hopkira/k9-chess-angular/tessel/README.md

# Tessel 2 Controller

Tessel 2 is not currently used in the design of the robot, with the LIDAR and ADC being monitored directly by the Pi
