hopkira/k9-chess-angular/img/Androids of Tara - Doctor talking to K9.png

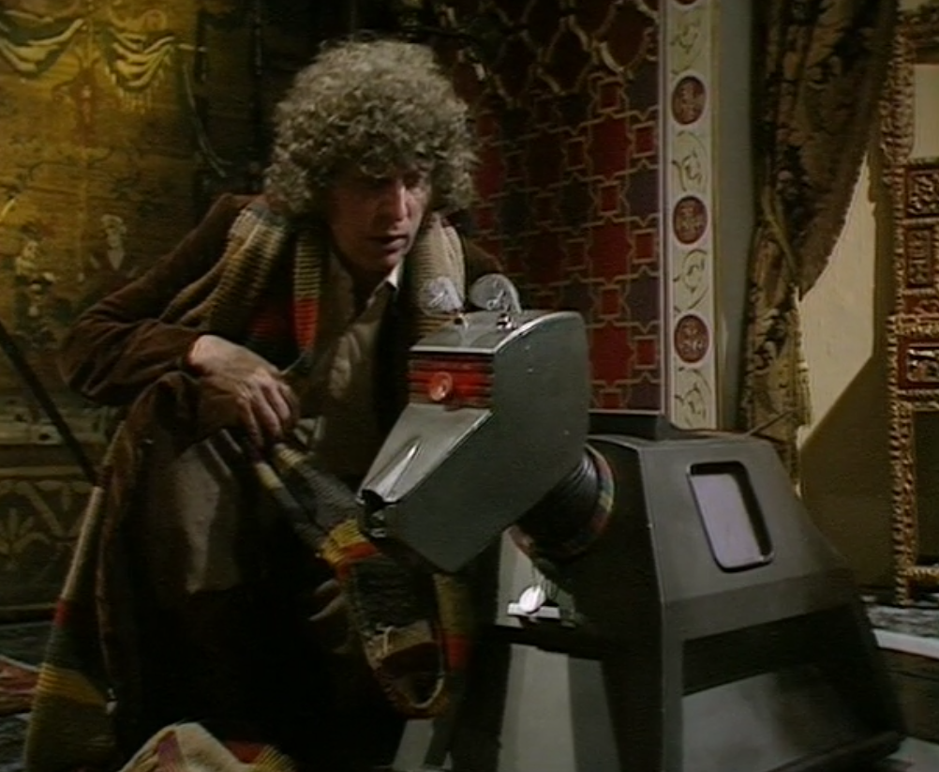
img/Androids of Tara - Doctor talking to K9.png
