hopkira/k9-chess-angular/img/Androids of Tara - headshot in lodge.png

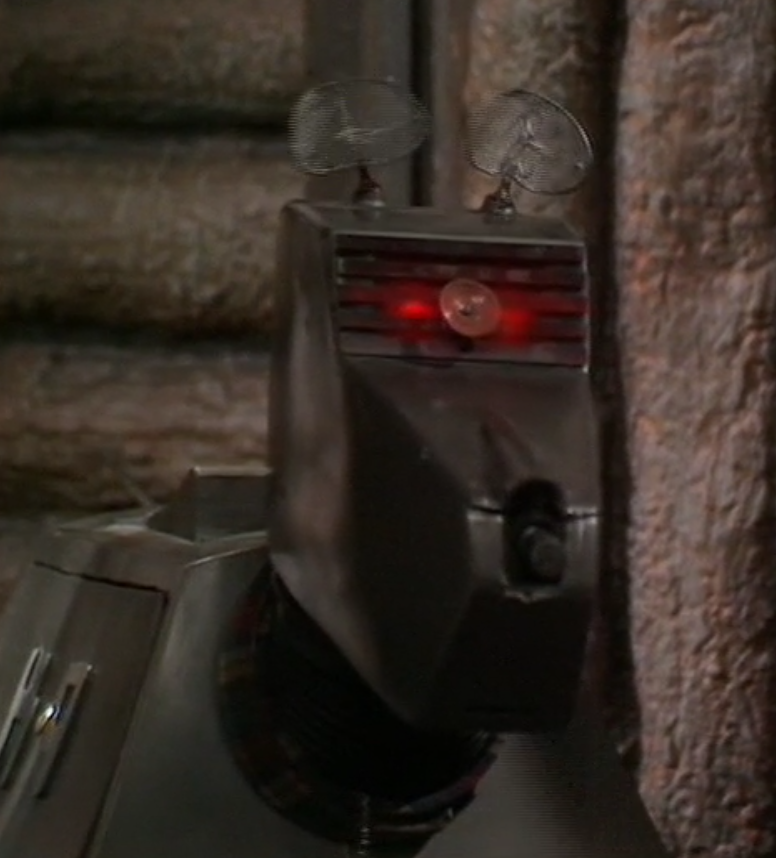
img/Androids of Tara - headshot in lodge.png
