hopkira/k9-chess-angular/img/Androids of Tara - K9 firing laser.png

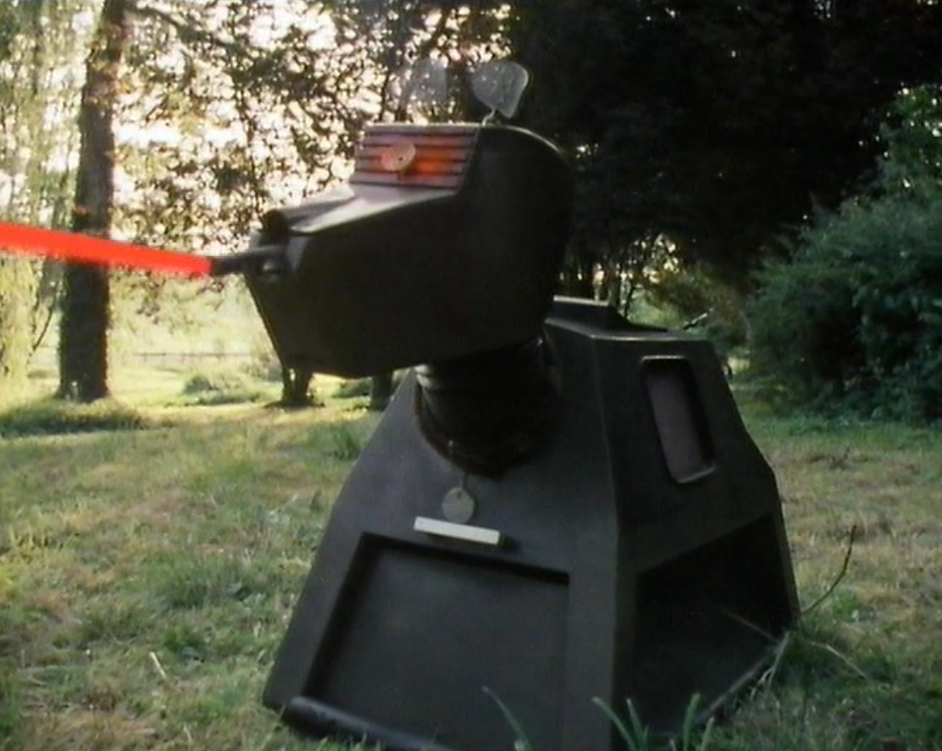
img/Androids of Tara - K9 firing laser.png
