hopkira/k9-chess-angular/img/Androids of Tara - playing chess.png

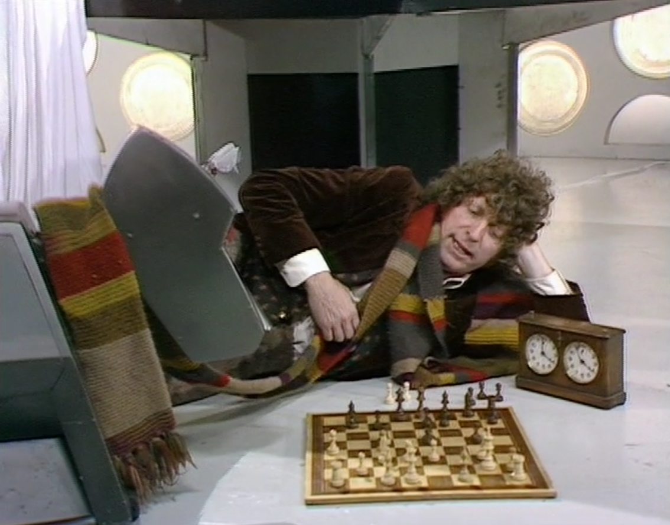
img/Androids of Tara - playing chess.png
