hopkira/k9-chess-angular/img/Androids of Tara - side view in lodge.png

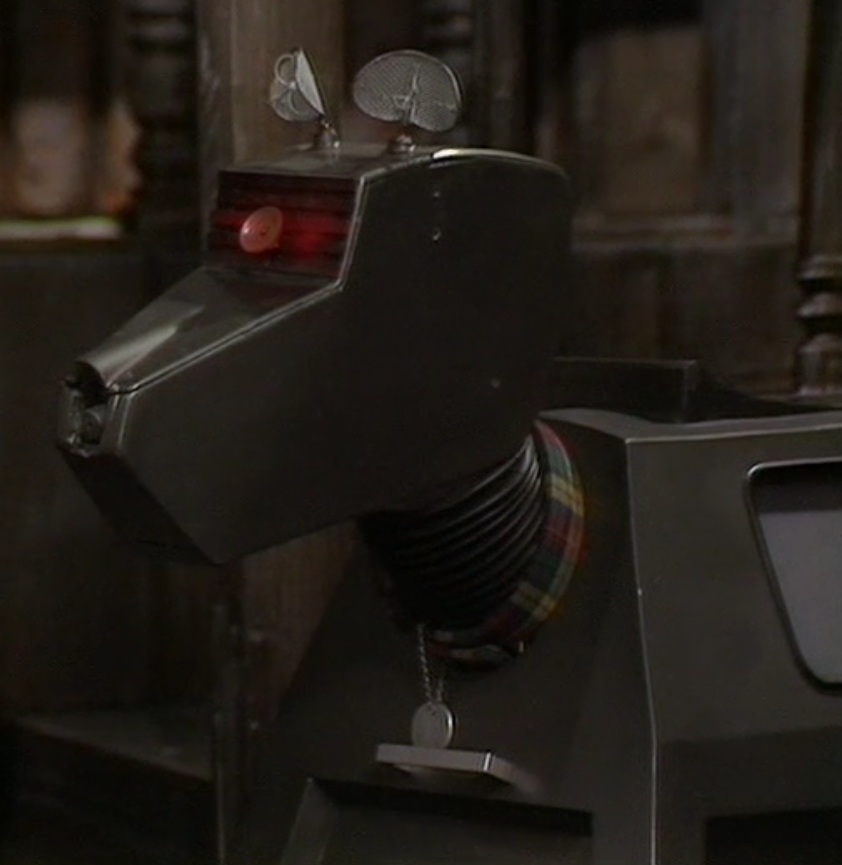
img/Androids of Tara - side view in lodge.png
