hopkira/k9-chess-angular/img/Androids of Tara - sitting by console.png

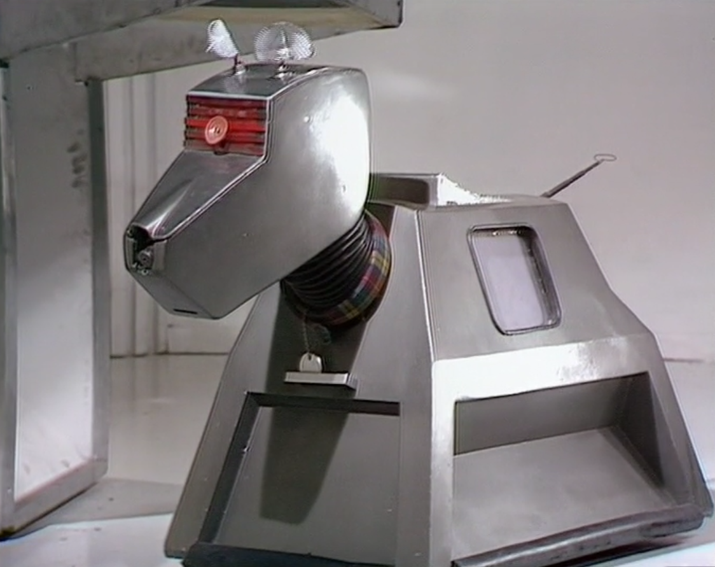
img/Androids of Tara - sitting by console.png
