hopkira/k9-chess-angular/img/Androids ot Tara - console room head shot.png

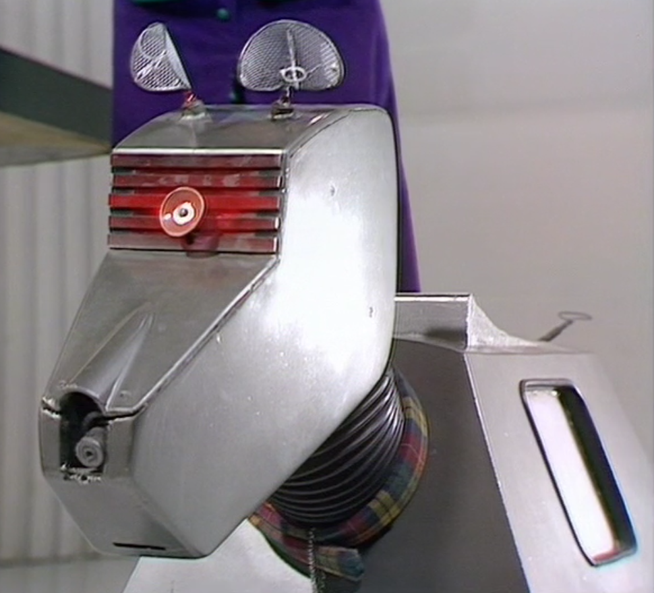
img/Androids ot Tara - console room head shot.png
