hopkira/k9-chess-angular/img/joystick.png

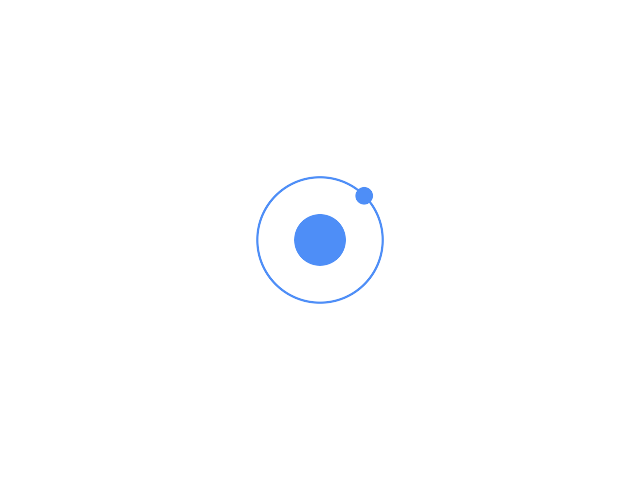
img/joystick.png
