hopkira/k9-chess-angular/img/K9-Camera-Image.png

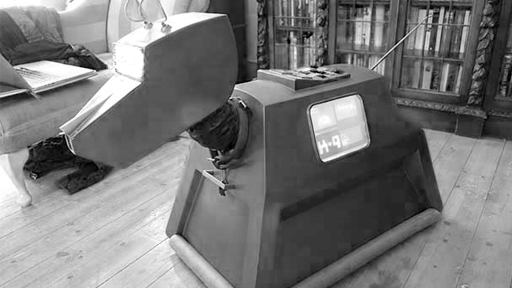
img/K9-Camera-Image.png
