hopkira/k9-chess-angular/models/120mm encoder (3.33m gap, 200 clicks).stl

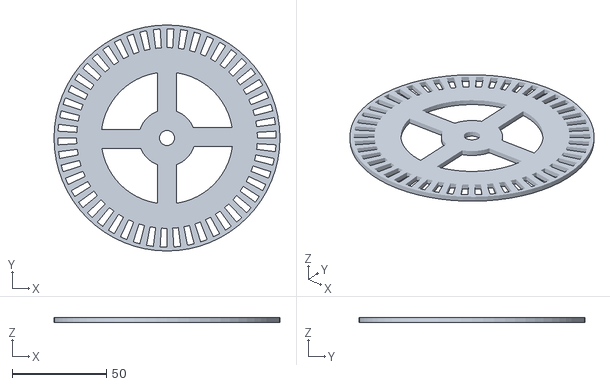
[picture p22: CAD file, 2020-01-11]
models/120mm encoder (3.33m gap, 200 clicks).stl
120.0 x 120.0 x 2.50
