hopkira/k9-chess-angular/models/Motherboard pillars (front).stl

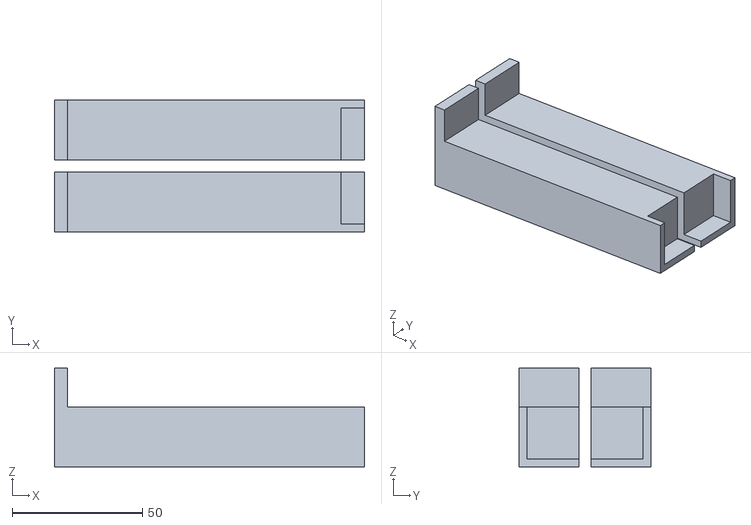
[picture p23: CAD file, 2018-09-10]
models/Motherboard pillars (front).stl
119.0 x 50.5 x 38.0
