hopkira/k9-chess-angular/models/Second tier velcro pillars.stl

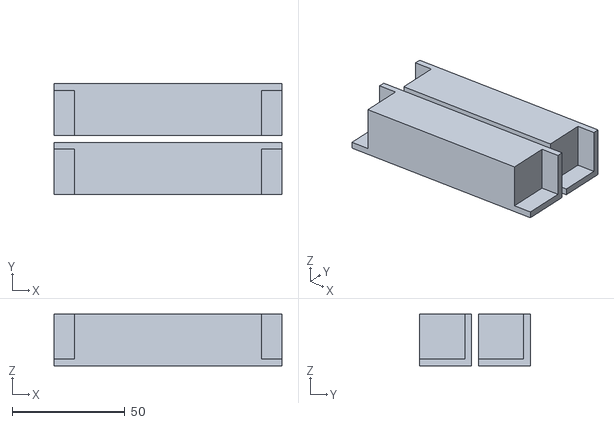
[picture p24: CAD file, 2018-09-10]
models/Second tier velcro pillars.stl
101.0 x 49.0 x 23.0
