hopkira/k9-chess-angular/models/K9 motor velco tops.stl

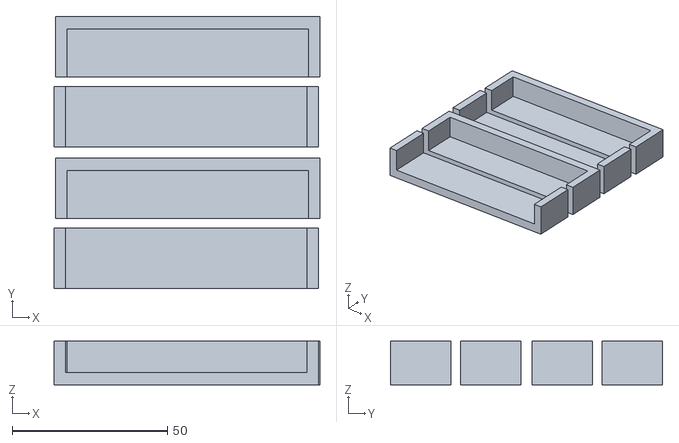
[picture p25: CAD file, 2018-09-10]
models/K9 motor velco tops.stl
85.5 x 87.5 x 14.0
