hopkira/k9-chess-angular/models/K9 Ears Servo Arms.stl

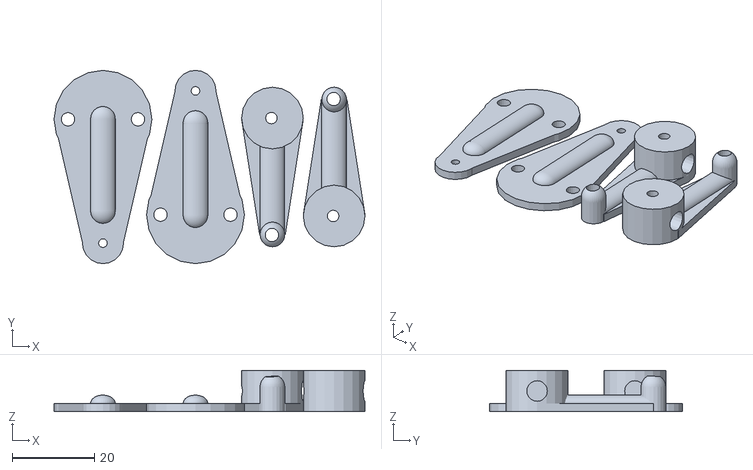
[picture p26: CAD file, 2018-09-10]
models/K9 Ears Servo Arms.stl
75.6 x 47.0 x 10.0
