hopkira/k9-chess-angular/models/K9 logo.stl

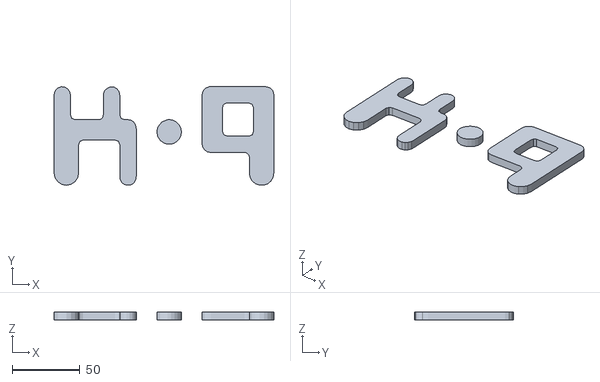
[picture p27: CAD file, 2018-09-10]
models/K9 logo.stl
162.8 x 73.0 x 6.00
