hopkira/k9-chess-angular/models/Wheel Encoder Holder.stl

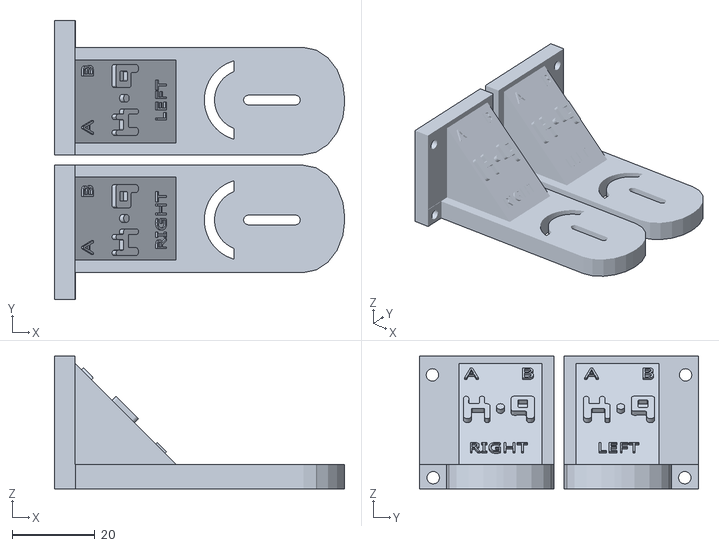
[picture p28: CAD file, 2018-09-10]
models/Wheel Encoder Holder.stl
70.0 x 67.3 x 32.0
