hopkira/k9-chess-angular/models/K9 Infrared Back Panel (IR).stl

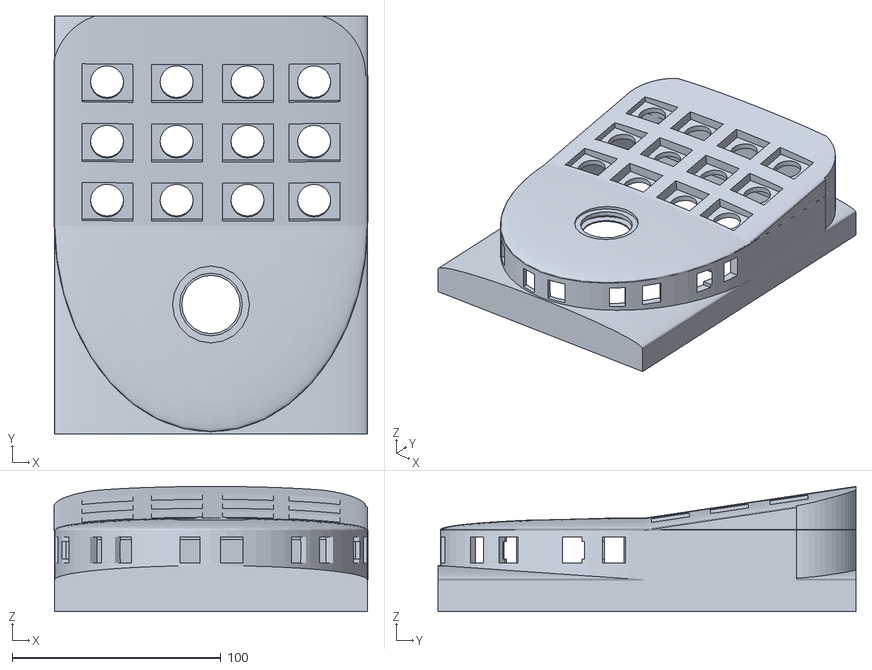
[picture p29: CAD file, 2018-09-10]
models/K9 Infrared Back Panel (IR).stl
150.0 x 200.0 x 59.9
