hopkira/k9-chess-angular/(list of files, cad)

Other CAD files:
models/K9 Motor Housing.skp
