hopkira/k9-chess-angular/(threads)

Thread 1 (2017-05-30):

Getting more done in GitHub with ZenHub

hopkira, 2017-05-30:
Hola! @hopkira has created a [ZenHub](http://www.zenhub.com) account for the **hopkira** organization. ZenHub is the only project management tool integrated natively in GitHub – created specifically for fast-moving, software-driven teams.

----

#### How do I use ZenHub?

To get set up with ZenHub, all you have to do is **[download the browser extension](https://www.zenhub.com?utm_source=ZHOnboarding)** and log in with your GitHub account. Once you do, you’ll get access to ZenHub’s complete feature-set immediately.

#### What can ZenHub do?

ZenHub adds a series of enhancements directly inside the GitHub UI:

- Real-time, customizable task boards for GitHub issues;
- Multi-Repository burndown charts, estimates, and velocity tracking based on GitHub Milestones;
- Personal to-do lists and task prioritization;
- Time-saving shortcuts – like a quick repo switcher, a “Move issue” button, and much more.

### [Add ZenHub to GitHub](https://www.zenhub.com?utm_source=ZHOnboarding)

_Still curious? See [more ZenHub features](https://www.zenhub.com/features?utm_source=ZHOnboarding) or read [user reviews](https://chrome.google.com/webstore/detail/zenhub-for-github/ogcgkffhplmphkaahpmffcafajaocjbd/reviews). This issue was written by your friendly ZenHub bot, posted by request from @hopkira._

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

Thread 11 (2017-06-06):

Create sensor driver that sends LIDAR messages to node-RED

hopkira, 2017-06-06:

amitmangalvedkar, 2017-06-15:
From where can I procure a LIDAR? I saw the following available https://www.protocentral.com/search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
But these seem to be pretty costly. Are there any cheaper alternatives available? Or best case can we use simulated data till an actual device is procured? If yes, what is the mode of communication between Pi and Node-RED? - HTTP / MQTT / WebSocket?

hopkira, 2017-06-15:
Hi Amit,
I've posted quite extensively on this on the #chess-dog-design channel on our Slack channel (https://ibmaot.slack.com/home).  The discussion includes pictures and a link to the cheap LIDAR we're using.  I've created a test harness so that we don't all need to buy LIDAR and IR sensors to try and come up with some good collision detection algorithms.
The harness currently sends simulated readings via websockets to node-RED.  The code is here: https://github.com/hopkira/k9-chess-angular/blob/master/python/harness.py

Closed 2019-01-07.

Thread 14 (2017-06-06):

Create stop/turn interface between collision detection algorithm and motor controller

hopkira, 2017-06-06:

Thread 2 (2017-06-06):

Block high speed reverse, turn and spin maneuvers

hopkira, 2017-06-06:
Modification to Python Motor Controller

Thread 20 (2017-06-06):

Create follow me button and voice interface

hopkira, 2017-06-06:

amitmangalvedkar, 2017-06-15:
I am trying to understand the flow here and the need for UI. I believe this is what is needed -
1. End  user says "Follow me"
2. The microphone always keeps running and when it hears any word, it sends the voice message to Watson Speech to Text
3. Watson Speech to Text convert this into a textual message
4. The text message is send back to K9 after which K9 keeps following the source.
Is this ok?
If yes, then
1. What is the role of UI?
2. How does K9 understand whom to follow?

hopkira, 2017-06-15:
Hi Amit, great questions!

**Voice flow**
I already have a voice interface that uses Watson Developer Cloud and Kitt-AI Snowboy https://github.com/hopkira/k9-chess-angular/blob/master/python/ttsrobot.py .  You activate that interface by saying "K9" (to Snowboy, which then activates STT) and then "Follow me", "Heel" or similar.  Watson Conversation will determine the intent and then communicate something back to the Python program that will kick off the behaviour.  YouTube video here: https://www.youtube.com/watch?v=Cv-R68gX724 and blog post here: http://k9-build.blogspot.co.uk/2016/12/eyes.html . This should be a very quick change.  We will also need a 'K9, stop following me' kind of intent too....

**Who to follow**
In terms of who to follow, we are going to cheat; the target will hold a hand-held ultrasonic dog whistle - video here https://www.youtube.com/watch?v=l6HSeQ8ULhQ and blog post http://k9-build.blogspot.co.uk/2017/06/tube.html

**Role of the UI**
There is also an Ionic/Cordova hybrid controlller (currently optimised for iPhone) where it would be good to have the ability to activate and deactivate the Follow Me behaviour.  The scenario to use this facility is likely to be when we need to activate or deactivate the Follow Me behaviour in a noisy environment (plus it is always good to have a secondary control mechanism).  The controller has a number of tabs, one of which shows the collision detection sensor data.  I think it is logical that the Follow Me switch should be on that tab (along with a visual indicator of where K9 thinks his target is too).  The sensor tab is more for debugging purpose as it doesn't actually do anything currently, but it does look cool.  Video here https://www.youtube.com/watch?v=VzLbTBhyGxg and blog http://k9-build.blogspot.co.uk/2016/05/a-dogs-eye-view.html .

Thread 3 (2017-06-06):

Create a safe-driving robot aware of it's surroundings

hopkira, 2017-06-06:
Enhance the existing robot with the ability to sense its environment and make automated changes to its direction and speed based on input from sensors.  This should include the ability to stop and make minor corrections to avoid obstacles.  It should also include the ability to stop the robot from entering into dangerous maneuvers.  This includes spinning or turning at high speed, spinning when not enough room or reversing at high speed.

Thread 4 (2017-06-06):

Create a follow-me robot that responds automatically to a ultrasonic transducer

hopkira, 2017-06-06:
Replace the manual guidance of the robot with the ability to follow a hand-held ultrasonic transducer (transmitter).  This will require multiple ultrasonic receivers around the body of the robot to enable the direction of the sound to be quickly deduced.
The resulting activity should be constrained by the same safe driving algorithms as the manual control.

Thread 5 (2017-06-06):

Create test harness that provides fake sensor data to test collision detection algorithms

hopkira, 2017-06-06:

Closed 2019-01-07.

Thread 7 (2017-06-06):

Create a collision detection algorithm for the robot

hopkira, 2017-06-06:
Minimum definition of done:
- Works with sensor data provided as per test harness
- 99.9% accuracy based on simulated data set
- Robot modeled as 1125mm x 445mm rectangle
- Collision processing on Raspberry Pi
- Collision detection based on 27 readings at low speeds and 13 readings at high speed

Desirable acceptance criteria:
- Robot modeled as 8 sided convex polygon or better
- Collision processing offloaded to Espruino
- Collision detection based on >27 readings at low speed

Thread 36 (2017-08-22):

Create 'Follow Me' Page

hopkira, 2017-08-22:
Create a follow me page on the Angular 2 framework.

Page should include:
K9 eye camera
visualization of proximity sensor feeds
visualization of ultrasonic follow me signals
basic minimum controls (heel/stay, emergency stop, get out of the way)

Thread 39 (2018-03-31):

Sending Transcription to conversation and getting response.

DrTardis1963, 2018-03-31:
(Excuse my poor writing its late) So how would I send the output of the transcription to Watson Conversation and then get the reply back as a string?

DrTardis1963, 2018-03-31:
Sorry to be a pain but im still getting this error
Traceback (most recent call last):
  File "/home/pi/K9/k9-chess-angular-master/python/richard.py", line 91, in <module>
    answer = results.group(1)
AttributeError: 'NoneType' object has no attribute 'group'

DrTardis1963, 2018-03-31:
Same output on conversation test
Traceback (most recent call last):
  File "/home/pi/K9/k9-chess-angular-master/python/richard test.py", line 31, in <module>
    answer = results.group(1)
AttributeError: 'NoneType' object has no attribute 'group'

DrTardis1963, 2018-03-31:
same again this has got me confused

{u'entities': [], u'intents': [{u'confidence': 0.3141396760940552, u'intent': u'about_VA'}], u'output': {u'text': [u'I am K9. Who are you?'], u'log_messages': [], u'nodes_visited': [u'Start And Initialize Context']}, u'context': {u'musiconoff': u'off', u'appl_action': u'', u'heateronoff': u'off', u'lightonoff': u'off', u'system': {u'dialog_stack': [{u'dialog_node': u'root'}], u'dialog_request_counter': 1, u'dialog_turn_counter': 1, u'branch_exited': True, u'_node_output_map': {u'Start And Initialize Context': [0, 2, 0, 1]}, u'branch_exited_reason': u'completed'}, u'default_counter': 0, u'volumeonoff': u'off', u'conversation_id': u'11b5e10a-9129-4614-9d15-bd845bb9b37b', u'wipersonoff': u'off', u'AConoff': u'off'}, u'input': {u'text': u'what is your purpose'}}
None

Traceback (most recent call last):
  File "/home/pi/K9/k9-chess-angular-master/python/testcode2.py", line 34, in <module>
    answer = results.group(1)
AttributeError: 'NoneType' object has no attribute 'group'

DrTardis1963, 2018-03-31:
Got this now

{u'entities': [], u'intents': [{u'confidence': 0.3141396760940552, u'intent': u'about_VA'}], u'output': {u'text': [u'K9 is ready.'], u'log_messages': [], u'nodes_visited': [u'Start And Initialize Context']}, u'context': {u'musiconoff': u'off', u'appl_action': u'', u'heateronoff': u'off', u'lightonoff': u'off', u'system': {u'dialog_stack': [{u'dialog_node': u'root'}], u'dialog_request_counter': 1, u'dialog_turn_counter': 1, u'branch_exited': True, u'_node_output_map': {u'Start And Initialize Context': [0, 1, 0, 2]}, u'branch_exited_reason': u'completed'}, u'default_counter': 0, u'volumeonoff': u'off', u'conversation_id': u'b73cc841-2562-4974-8324-39cfe5cc88a8', u'wipersonoff': u'off', u'AConoff': u'off'}, u'input': {u'text': u'what is your purpose'}}
<_sre.SRE_Match object at 0x750b19a0>
./tts K9 is ready.

DrTardis1963, 2018-03-31:
ok its a shell script but i still get
Lights on
Lights off
hello
./tts I am K9. Who are you?
and no sound

Closed 2018-03-31.

Thread 41 (2018-04-01):

Twisted error Reactor not Restartable

DrTardis1963, 2018-04-01:
So Everything works :) :1st_place_medal:   Also Happy Easter :)
So I run the program whether it be the loop or the program itself, I say K9 and snowboy detects it, then I say Hello, He says Hello I am K9, then snowboy waits to detect again, I say K9 and snowboy detects it, then it says lights on I say What time is it, but the transcription doesnt show up, it says lights off and then this error appears. I know the error is about the Speech to Text service because I copied the code below and pasted it after tts is called and it gives the same error The error is happening after it detects k9 and second time and begins to transcribe or in the case where i pasted it happens immediately upon running the code below Error is further down
with open('my_voice.wav') as f:
        speech_to_text.recognize_with_websocket(audio=f,content_type='audio/l16; rate=44100', recognize_callback=mycallback)
    while not finished:
        time.sleep(0.1)

Traceback (most recent call last):
  File "/home/pi/K9/k9-chess-angular-master/python/working.py", line 10, in <module>
    import os, sys, subprocess, threading, time, json, re, signal, snowboydecoder, working
  File "/home/pi/K9/k9-chess-angular-master/python/working.py", line 139, in <module>
    speech_to_text.recognize_with_websocket(audio=f,content_type='audio/l16; rate=44100', recognize_callback=mycallback)
  File "/usr/local/lib/python2.7/dist-packages/watson_developer_cloud/speech_to_text_v1.py", line 279, in recognize_with_websocket
    RecognizeListener(audio, options, recognize_callback, url, headers)
  File "/usr/local/lib/python2.7/dist-packages/watson_developer_cloud/websocket/speech_to_text_websocket_listener.py", line 47, in __init__
    reactor.run() # pylint: disable=E1101
  File "/home/pi/.local/lib/python2.7/site-packages/twisted/internet/base.py", line 1242, in run
    self.startRunning(installSignalHandlers=installSignalHandlers)
  File "/home/pi/.local/lib/python2.7/site-packages/twisted/internet/base.py", line 1222, in startRunning
    ReactorBase.startRunning(self)
  File "/home/pi/.local/lib/python2.7/site-packages/twisted/internet/base.py", line 730, in startRunning
    raise error.ReactorNotRestartable()
ReactorNotRestartable

DrTardis1963, 2018-04-01:
Ran the assistant program got this

200
Calling listen_for_K9
Listening for K9 keyword... press Ctrl+C to exit
INFO:snowboy:Keyword 1 detected at time: 2018-04-02 09:04:26
K9 detected

Calling speech_to_text
stt_client initialisation
opened(self) and self.send
Received: {u'state': u'listening'}
Speak now...
Received: {u'error': u'Session timed out.'}
no speech heard for 30 seconds, exiting
Exception in thread WebSocketClient:
Traceback (most recent call last):
  File "/usr/lib/python2.7/threading.py", line 801, in __bootstrap_inner
    self.run()
  File "/usr/lib/python2.7/threading.py", line 754, in run
    self.__target(*self.__args, **self.__kwargs)
  File "/home/pi/.local/lib/python2.7/site-packages/ws4py/websocket.py", line 528, in run
    if not self.once():
  File "/home/pi/.local/lib/python2.7/site-packages/ws4py/websocket.py", line 410, in once
    if not self.process(self.buf[:requested]):
  File "/home/pi/.local/lib/python2.7/site-packages/ws4py/websocket.py", line 480, in process
    self.received_message(s.message)
  File "/home/pi/K9/k9-chess-angular-master/python/assistant.py", line 117, in received_message
    self.close()
  File "/home/pi/K9/k9-chess-angular-master/python/assistant.py", line 139, in close
    self.stream_audio_thread.join()
AttributeError: 'SpeechToTextClient' object has no attribute 'stream_audio_thread'
To conversation: silence

Traceback (most recent call last):
  File "/home/pi/K9/k9-chess-angular-master/python/assistant.py", line 197, in <module>
    answer = results.group(1)
AttributeError: 'NoneType' object has no attribute 'group'

DrTardis1963, 2018-04-02:
Sorry I didn't read your blog post I just read it then and followed all the steps and It works splendidly, with no errors whatsoever just had a decent conversation with K9 but I still need to add a lot to watson on my end THANKYOU for all the help you have given me these past few days I know it must have been annoying having a new error to deal with every other 2 hours so thank you. Looking forward to seeing more amazing stuff that you will definetely achieve if your past work is anything to go by.
Sincerely,
Blake

Closed 2018-04-02.
