hopkira/k9-chess-angular/python/K9PythonController.py

#
# K9 Python Controller
#
# authored by Richard Hopkins, 2017-2020
#
# Licensed under The Unlicense, so free for public domain use
#
# This program performs receives two different command strings
# of type 'navigation' routed from a local node-RED instance.
#
# In response to the 'browser' command (a heartbeat
# every 250ms generated in the brower)
# it will respond with status information about
# the driving motors and other information
# e.g. status of lights.
# Node-RED will then route this information to the end user browser.
#
# In response to the 'motors' command,
# the controller will calculate the respective motor speeds
# and send a message to the Roboclaw to move K9
# at that speed and direction for 30 cm.
#
import sys     # allows for command line to be interpreted
import json    # enables creation of JSON strings
import os      # enables access to environment variables
import math    # import maths operations
import random  # import random numbers
import time    # enable sleep function
import memory  # import K9 memory functions using Redis
from ws4py.client.threadedclient import WebSocketClient  # enabling web sockets

sys.path.append('/home/pi')  # persistent import directory for K9 secrets
sys.path.append('/home/pi/Adafruit_Python_PCA9685/Adafruit_PCA9685')
# persistent directory for Adafruit driver
sim = False  # by default run as a real motor controller
ACCELERATION = 128  # accelerate to top speed in 5s
M1_QPPS = 1987   # max speed of wheel in clicks per second
M2_QPPS = 1837
M1_P = 10.644  # Proportional element of feedback for PID controller
M2_P = 9.768
M1_I = 2.206  # Integral element of feedback for PID controller
M2_I = 2.294
M1_D = 0.0  # Derived element of feedback for PID controller
M2_D = 0.0

# sim is a program wide flag to allow the program to run without the Roboclaw
# this can be enabled by appending the word "test" to the command line

if (len(sys.argv) > 1):
    if (sys.argv[1] == "test"):
        sim = True
        print "Executing in simulation mode"

# If running for real initialise remote socket, roboclaw driver
if not sim:
    print "Importing servo driver library..."
    import Adafruit_PCA9685  # enable control of devices
    from k9secrets import K9PyContWS  # gets the node-RED websocket address
    address = K9PyContWS
    print "Node-RED address is: " + str(address)
    #  Initialise the roboclaw motorcontroller
    print "Initialising roboclaw driver..."
    from roboclaw import Roboclaw
    rc = Roboclaw("/dev/roboclaw", 115200)
    rc.Open()
    rc_address = 0x80
    # Get roboclaw version to test if is attached
    version = rc.ReadVersion(rc_address)
    if version[0] is False:
        print "Roboclaw get version failed"
        sys.exit()
    else:
        print repr(version[1])
        # Set motor controller variables to those required by K9
        rc.SetM1VelocityPID(rc_address, M1_P, M1_I, M1_D, M1_QPPS)
        rc.SetM2VelocityPID(rc_address, M2_P, M2_I, M2_D, M2_QPPS)
        rc.SetMainVoltages(rc_address,232,290) # 23.2V min, 29V max
        rc.SetPinFunctions(rc_address,2,0,0)
        # Zero the motor encoders
        rc.ResetEncoders(rc_address)
        # Print Motor PID Settings
        m1pid = rc.ReadM1VelocityPID(rc_address)
        m2pid = rc.ReadM2VelocityPID(rc_address)
        print("M1 P: " + str(m1pid[1]) + ", I:" + str(m1pid[2]) + ", D:" + str(m1pid[3]))
        print("M2 P: " + str(m2pid[1]) + ", I:" + str(m2pid[2]) + ", D:" + str(m2pid[3]))
        # Print Min and Max Main Battery Settings
        minmaxv = rc.ReadMinMaxMainVoltages(rc_address) # get min max volts
        print ("Min Main Battery: " + str(int(minmaxv[1])/10) + "V")
        print ("Max Main Battery: " + str(int(minmaxv[2])/10) + "V")
        # Print S3, S4 and S5 Modes
        S3mode=['Default','E-Stop (latching)','E-Stop','Voltage Clamp','Undefined']
        S4mode=['Disabled','E-Stop (latching)','E-Stop','Voltage Clamp','M1 Home']
        S5mode=['Disabled','E-Stop (latching)','E-Stop','Voltage Clamp','M2 Home']
        pinfunc = rc.ReadPinFunctions(rc_address)
        print ("S3 pin: " + S3mode[pinfunc[1]])
        print ("S4 pin: " + S4mode[pinfunc[2]])
        print ("S5 pin: " + S5mode[pinfunc[3]])
        print("Roboclaw motor controller initialised...")
else:
    # otherwise use local host as node-RED server
    # and don't initialise GPIO or Roboclaw
    address = "ws://127.0.0.1:1880/ws/motors"


class Motor:
    def __init__(self, name, QPPS):
        self.name = name
        self.QPPS = QPPS/100.0
        print str(name) + " motor object instantiated."
        self.speed = 0.0
        self.target = 0.0
        self.encoder = 0.0

    def calculateTargetSpeed(self, reqmotorspeed, reqsteering, motorctrl):
        self.reqmotorspeed = reqmotorspeed
        self.reqsteering = reqsteering
        self.motorctrl = motorctrl
        # Modify the instructions to restrict turning
        # component to 25% of full speed
        # by applying an elipse as the limiter
        self.myAngle = math.atan2(self.reqmotorspeed, self.reqsteering)
        if (self.reqmotorspeed >= 0):
            self.reqmotorspeed = self.reqmotorspeed * math.sin(self.myAngle)
        else:
            self.reqmotorspeed = \
                self.reqmotorspeed * math.sin(self.myAngle) * -1
        if (self.reqsteering >= 0):
            self.reqsteering = \
                self.reqsteering * math.cos(self.myAngle) * 0.25
        else:
            self.reqsteering = \
                self.reqsteering * math.cos(self.myAngle) * -0.25
        self.magnitude = min(100.0, math.sqrt(math.pow(
                self.reqmotorspeed, 2.0) + math.pow(self.reqsteering, 2.0)))
        # If motorctrl is 1, then translate into precise
        # speed and direction up to 10mph
        print "Speed: " + str(self.reqmotorspeed) + " Steering: " + \
            str(self.reqsteering) + " Magnitude: " + str(self.magnitude)
        if (self.motorctrl != 1.0):
            # If motorctrl is not in turbo mode, then reduce
            # speed by 25%
            self.magnitude = self.magnitude / 4
            # and limit the angle of movement to forward, backward or spin
            self.myAngle = round(self.myAngle / (math.pi/4.0))*math.pi/4.0
        # Rotate the frame of reference by 45 degrees to translate into motor
        # speeds
        self.myAngle = self.myAngle - (math.pi/4.0)
        if self.name == "left":
            self.targetspeed = self.magnitude * math.cos(self.myAngle)
        elif self.name == "right":
            self.targetspeed = self.magnitude * math.sin(self.myAngle)
        else:
            print "Unknown motor"
            self.targetspeed = 0
        return self.targetspeed

    def getActualSpeed(self):
        self.clicks = 0
        if not sim:
            if self.name == "left":
                self.clicks = rc.ReadSpeedM1(rc_address)
                self.encoder_raw = rc.ReadEncM1(rc_address)
            elif self.name == "right":
                self.clicks = rc.ReadSpeedM2(rc_address)
                self.encoder_raw = rc.ReadEncM2(rc_address)
            else:
                print "Unknown motor"
                self.speed = 0
                self.encoder = 0
            self.speed = int(self.clicks[1] / self.QPPS)
            self.encoder = int(self.encoder_raw[2])
        else:
            self.speed = self.target
            self.encoder = self.encoder + self.speed
        # print str(self.name) + " speed: " + str(self.speed)
        # print str(self.name) + " encoder: " + str(self.encoder)
        # Store current speed and encoder reading in K9 memory
        memory.storeState(str(self.name)+":speed", self.speed)
        memory.storeState(str(self.name)+":encoder", self.encoder)
        return self.speed

    def setTargetSpeed(self, target):
        if target >= -100 and target <= 100:
            self.target = int(target)

    def setMotorSpeed(self):
        if not sim:
            self.click_speed = int(self.QPPS * self.target)
            self.distance = int(abs(self.target * self.QPPS / 4))
            # print "Command: " + str(self.name) + " set to " +\
            #    str(self.click_speed)
            if self.name == "left":
                if self.target == 0:
                    rc.SpeedM1(rc_address, 0)
                else:
                    rc.SpeedAccelM1(rc_address,ACCELERATION,self.click_speed)
                    #rc.SpeedM1(rc_address, self.click_speed)
            elif self.name == "right":
                if self.target == 0:
                    rc.SpeedM2(rc_address, 0)
                else:
                    rc.SpeedAccelM2(rc_address,ACCELERATION,self.click_speed)
                    rc.SpeedM2(rc_address, self.click_speed)
            else:
                print "Unknown motor"


class K9:
    def __init__(self):
        print "K9 object initialising"
        # Create names for each PWM channel
        self.pwm_eyes = 0
        self.pwm_hover = 3
        self.pwm_screen = 6
        self.pwm_lights = 1
        self.pwm_tailv = 4
        self.pwm_tailh = 5
        # Set initial values for k9
        self.lights = 100
        self.eyes = 5
        self.hover = 0
        self.screen = 100
        self.tailv = 14.04
        self.tailh = 15.02
        self.motorctrl = 0
        # Create two motor objects
        self.leftMotor = Motor("left", M1_QPPS)
        self.rightMotor = Motor("right", M2_QPPS)
        if not sim:
            # Initialise the PWM device using the default address
            # This is the Adafruit servo control device that makes the tail,
            # neck and ears move; it also is used to turn control the various
            # lights and devices such as the eye and hover lights and the
            # side screen using MOSFETS
            print "Initialising servo driver state..."
            self.pwm = Adafruit_PCA9685.PCA9685()
            print "pwm object created"
            self.pwm.set_pwm_freq(100)  # Set frequency to 100 Hz
            print "frequency set to 100Hz"
            self.set_k9_pwm(self.pwm_eyes, self.eyes)
            self.set_k9_pwm(self.pwm_hover, self.hover)
            self.set_k9_pwm(self.pwm_screen, self.screen)
            self.set_k9_pwm(self.pwm_lights, self.lights)
            print "Tail vertical..."
            self.set_k9_pwm(self.pwm_tailv, self.tailv)
            print "Tail horizontal"
            self.set_k9_pwm(self.pwm_tailh, self.tailh)
            print "All servo driver initial state set..."
            print "k9 instance of K9 Class initialized"

    def switch_obj_to_channel(self, object):
        convert = {
            "eyes": 0,
            "lights": 1,
            "screen": 6,
            "hover": 3,
            "tailv": 4,
            "tailh": 5
        }
        return convert.get(object)

    def set_k9_object(self, object, brightness):
        self.brightness = float(brightness)
        self.pwm_channel = self.switch_obj_to_channel(object)
        self.set_k9_pwm(self.pwm_channel, self.brightness)

    def set_k9_pwm(self, channel, brightness):
        self.channel = int(channel)
        self.brightness = int(brightness * 40.95)
        # print "Setting channel " +\
        #    str(self.channel) + " to " + str(self.brightness)
        if not sim:
            self.pwm.set_pwm(self.channel, 0, self.brightness)
        # print "Channel " + str(self.channel) +\
        #    " set to " + str(self.brightness)

    def getStatusInfo(self):
        # retrieves status of motors and lights
        # lights are part of the k9 state object anyway
        self.result = []
        self.left = self.leftMotor.getActualSpeed()
        self.right = self.rightMotor.getActualSpeed()
        if sim:
            self.main_volt = float(random.uniform(12, 28))
            self.brain_volt = float(random.uniform(10, 13))
            self.currents = [
                100.0, random.uniform(100, 500), random.uniform(100, 500)]
            self.temp = float(random.uniform(20, 85))
        else:
            self.main_volt = float(
                rc.ReadMainBatteryVoltage(rc_address)[1])/10.0
            self.brain_volt = float(
                rc.ReadLogicBatteryVoltage(rc_address)[1])/10.0
            self.currents = rc.ReadCurrents(rc_address)
            self.temp = float(rc.ReadTemp(rc_address)[1])/10.0
            # Convert currents tuple in mAs to Amps
        self.m1current = float(self.currents[1]/100.0)
        self.m2current = float(self.currents[2]/100.0)
        result = json.dumps({
            "type": "status",
            "command": "update",
            "left": self.left,
            "right": self.right,
            "lights": self.lights,
            "eyes": self.eyes,
            "hover": self.hover,
            "screen": self.screen,
            "motorctrl": self.motorctrl,
            "main_volt": self.main_volt,
            "brain_volt": self.brain_volt,
            "motor_l_amp": self.m1current,
            "motor_r_amp": self.m2current,
            "temp": self.temp},
            skipkeys=False,
            ensure_ascii=True,
            check_circular=True,
            allow_nan=True,
            cls=None,
            indent=None,
            separators=(',', ': '),
            encoding="utf-8",
            default=None,
            sort_keys=False)
        return result


# manages the ws socket connection
# from this Controller to local node-RED server
class K9PythonController(WebSocketClient):
    def opened(self):
        print "K9 Python Controller connected to node-RED server"
        self.k9 = K9()
        # self.timeout = Timer (50, self.closed(None,None) )
        # self.timeout.start()

    def closed(self, code, reason=None):
        print "K9 Python Controller disconnected from node-RED server: ",\
            code, reason
        self.k9.leftMotor.setTargetSpeed(0)
        self.k9.rightMotor.setTargetSpeed(0)
        self.k9.leftMotor.setMotorSpeed()
        self.k9.rightMotor.setMotorSpeed()
        # PBR.SetMotor1(0)
        # PBR.SetMotor2(0)
        # browser commands with type 'navigation' are automatically routed by
        # node-RED to this socket
        # the navigation 'alive' command (basically a heartbeat)
        # is sent automatically by the browser and relayed via node-RED.
        # On receiving the heartbeat message, from node-RED this controller
        # responds to the same socket
        # with the status of K9 as determined by this python program.
        # node-RED can then
        # forward the status string to the browser to display to the user
        # This round trip should provide a reliable indication
        # to the end user that
        # communications between the browser, node-RED and the motors
        # are working as expected

    def toggle_message(self):
        self.brightness = 0  # default to "off" value
        if (self.message_dict["object"] == "tailv"):
            if (self.message_dict["value"] == "up"):
                self.k9.set_k9_pwm(5, 15.02)  # centre tail
                self.k9.set_k9_pwm(4, 10.99)  # move up
            else:
                self.k9.set_k9_pwm(5, 15.02)  # centre tail
                self.k9.set_k9_pwm(4, 17.09)  # move up
        elif (self.message_dict["object"] == "tailh"):
            if (self.message_dict["value"] == "left"):
                self.k9.set_k9_pwm(4, 14.04)  # centre tail
                self.k9.set_k9_pwm(5, 12.82)  # move left
            else:
                self.k9.set_k9_pwm(4, 14.04)  # centre tail
                self.k9.set_k9_pwm(5, 17.22)  # move right
        else:
            if self.message_dict["value"] == "on":
                self.brightness = 100
            self.k9.set_k9_object(self.message_dict["object"], self.brightness)

    def servo_message(self):
        self.k9.set_k9_object(
            self.message_dict["object"], self.message_dict["value"])

    def received_message(self, message):
        self.message = message
        self.message = str(self.message)
        # turn message into JSON formatted string
        self.message_dict = []
        self.message_dict = json.loads(self.message)  # parse JSON to dict
        # do some stuff here to handle PWM and Toggle Messages
        if self.message_dict["type"] == "toggle":
            self.toggle_message()
        elif self.message_dict["type"] == "servo":
            self.servo_message()
        elif self.message_dict["type"] == "navigation":
            # navigation command received
            if self.message_dict["object"] == "browser":
                # heartbeat received from browser
                self.message = self.k9.getStatusInfo()
                # get K9 status information
                self.send(self.message)
                # send current status information to the node-RED websocket
                # print "Status: " + str(self.message)
            elif self.message_dict["object"] == "motorctrl":
                # toggle fine or coarse grained motor control
                if self.message_dict["value"] == "on":
                    self.k9.motorctrl = 1.0
                else:
                    self.k9.motorctrl = 0.0
            elif self.message_dict["object"] == "motors":
                # change the motor speeds
                # print "I heard:" + str(self.message_dict);
                self.motorspeed = float(self.message_dict["motorspeed"])
                self.steering = float(self.message_dict["steering"])
                self.leftTarget = self.k9.leftMotor.calculateTargetSpeed(
                    self.motorspeed, self.steering, self.k9.motorctrl)
                self.rightTarget = self.k9.rightMotor.calculateTargetSpeed(
                    self.motorspeed, self.steering, self.k9.motorctrl)
                # Calculate the magnitude of the movement calculated (0-100)
                # and make that the value of the hover brightness
                self.k9.hover = min(((
                    abs(self.leftTarget) + abs(self.rightTarget))/2), 100)
                # set the hover lights brightness
                self.k9.set_k9_pwm(self.k9.pwm_hover, self.k9.hover)
                # set the motor speeds
                self.k9.leftMotor.setTargetSpeed(self.leftTarget)
                self.k9.rightMotor.setTargetSpeed(self.rightTarget)
                self.k9.leftMotor.setMotorSpeed()
                self.k9.rightMotor.setMotorSpeed()
            else:
                # command could not be interpreted
                print "Command object not understood: " +\
                    str(self.message_dict)
        else:
            # not a navigation command
            print "Illegal command received: " + str(self.message_dict)


# Wait for node-RED server to become active
if not sim:
    # time.sleep(30)
    print "Not sleeping"
try:
    ws = K9PythonController(address)
    ws.connect()
    ws.run_forever()
except KeyboardInterrupt:
    if not sim:
        # reset motors to zero
        ws.k9.leftMotor.setTargetSpeed(0)
        ws.k9.rightMotor.setTargetSpeed(0)
        ws.k9.leftMotor.setMotorSpeed()
        ws.k9.rightMotor.setMotorSpeed()
        # GPIO.cleanup()
        ws.close()
        print "Exiting controller after cleanup."
