hopkira/k9-chess-angular/python/roboclaw_speedacceldistance.py

#***Before using this example the motor/controller combination must be
#***tuned and the settings saved to the Roboclaw using IonMotion.
#***The Min and Max Positions must be at least 0 and 50000

import time
from roboclaw import Roboclaw

#Windows comport name
rc = Roboclaw("COM9",38400)
#Linux comport name
#rc = Roboclaw("/dev/ttyACM0",115200)

def displayspeed():
	enc1 = rc.ReadEncM1(address)
	enc2 = rc.ReadEncM2(address)
	speed1 = rc.ReadSpeedM1(address)
	speed2 = rc.ReadSpeedM2(address)

	print("Encoder1:"),
	if(enc1[0]==1):
		print enc1[1],
		print format(enc1[2],'02x'),
	else:
		print "failed",
	print "Encoder2:",
	if(enc2[0]==1):
		print enc2[1],
		print format(enc2[2],'02x'),
	else:
		print "failed " ,
	print "Speed1:",
	if(speed1[0]):
		print speed1[1],
	else:
		print "failed",
	print("Speed2:"),
	if(speed2[0]):
		print speed2[1]
	else:
		print "failed "

rc.Open()
address = 0x80

version = rc.ReadVersion(address)
if version[0]==False:
	print "GETVERSION Failed"
else:
	print repr(version[1])

while(1):
	rc.SpeedAccelDistanceM1(address,12000,12000,42000,1);
	rc.SpeedAccelDistanceM2(address,12000,-12000,42000,1);
	rc.SpeedAccelDistanceM1(address,12000,0,0,0);  #distance travelled is v*v/2a = 12000*12000/2*48000 = 1500
	rc.SpeedAccelDistanceM2(address,12000,0,0,0);  #that makes the total move in one direction 48000
	buffers = (0,0,0)
	while(buffers[1]!=0x80 and buffers[2]!=0x80):	#Loop until distance command has completed
		print "Buffers: ",
		print buffers[1],
		print " ",
		print buffers[2]
		displayspeed();
		buffers = rc.ReadBuffers(address);
  
	time.sleep(1)

	rc.SpeedAccelDistanceM1(address,48000,-12000,46500,1);
	rc.SpeedAccelDistanceM2(address,48000,12000,46500,1);
	rc.SpeedAccelDistanceM1(address,48000,0,0,0);  #distance travelled is v*v/2a = 12000*12000/2*48000 = 1500
	rc.SpeedAccelDistanceM2(address,48000,0,0,0);  #that makes the total move in one direction 48000
	buffers = (0,0,0)
	while(buffers[1]!=0x80 and buffers[2]!=0x80):	#Loop until distance command has completed
		print "Buffers: ",
		print buffers[1],
		print " ",
		print buffers[2]
		displayspeed()
		buffers = rc.ReadBuffers(address)
  
	time.sleep(1);  #When no second command is given the motors will automatically slow down to 0 which takes 1 second
