hopkira/k9-chess-angular/python/circle.py

# -*- coding: utf-8 -*-
#
# Turn on the spot
#
# authored by Richard Hopkins March 2019
#
# Licensed under The Unlicense, so free for public domain use
#
# This program moves K9 in a circle

import math
from roboclaw import Roboclaw
rc = Roboclaw("/dev/roboclaw", 115200)
rc.Open()
rc_address = 0x80
m1_qpps = 1762
m2_qpps = 1050
acceleration = 100
speed = 500
distance = 300
# Get roboclaw version to test if is attached
version = rc.ReadVersion(rc_address)
# Set PID variables to those required by K9
rc.SetM1VelocityPID(rc_address, 8.55, 2.21, 0, m1_qpps)
rc.SetM2VelocityPID(rc_address, 8.96, 2.82, 0, m2_qpps)
# Zero the motor encoders
rc.ResetEncoders(rc_address)
rc.SpeedAccelDistanceM1M2(address=rc_address,
                          accel=acceleration,
                          speed1=int(-speed),
                          distance1=int(distance),
                          speed2=int(speed),
                          distance2=int(distance),
                          buffer=int(1))
rc.SpeedAccelDistanceM1M2(address=rc_address,
                          accel=655360,
                          speed1=int(-1),
                          distance1=int(distance),
                          speed2=int(-1),
                          distance2=int(distance),
                          buffer=int(0))
