hopkira/k9-chess-angular/python/logot_test.py

# -*- coding: utf-8 -*-
#
# K9's Movement Subsystem - Autonomous Motor Driver Test program
#
# authored by Richard Hopkins February 2018 for AoT Autonomy Team
#
# Licensed under The Unlicense, so free for public domain use
#
# This program tests the movement capability

import logo
import math

while memory.finished():
memory.forward(1)
while memory.finished():
while memory.left(math.pi/2)
while memory.finished():
memory.forward(1)
while memory.finished():
while memory.left(math.pi/2)
while memory.finished():
memory.forward(1)
while memory.finished():
while memory.left(math.pi/2)
while memory.finished():
memory.forward(1)
while memory.finished():
while memory.left(math.pi/2)
