hopkira/k9-chess-angular/(commit log)

2016-06-09 New motor and sensor function
    Significant updates to sensors and motor services and tabs. Minor
    changes to K9 Python Controller to assist with testing
2016-10-16 Corrected generation of URL for connection. Rounding of values of motor for better display in browser. Better error handling in Python Motor controller to allow for GetMotor to return None.
    [K9PythonController.py (backup).py]
2016-10-16 Added node-RED flows
    node-RED flows
2017-01-10 Python script for STT, Conversation and TTS
    Includes a script for a Python client to use Kitt.ai Snowboy for local
    phrase detection and IBM’s Watson for Speech to Text (streamed via web
    socket) and Conversation to return a response. Also included is the
    short tts.py script to provide K9 with a voice.
    [watsonsnow.py]
2017-01-14 Python script to improve user experience of talking to K9
    This script incorporates user feedback on whether K9 is listening or
    not by changing the brightness of his LED eye panels.
2017-01-14 Improving deployment pipeline by automatically inserting secrets using environment variables.
    Refined deployment script to include restarting the K9PythonController.
    Secret URLs and keys are now pulled into the Python program via
    environment variables.
2017-02-25 Encoder test script
    Simple Espruino JavaScript to enable standalone encoder testing
2017-03-11 Autostart changes
    Enhancements to deployment and startup scripts to enable all services
    to start cleanly after reboot and display the new node-RED dashboard on
    the side screen.
    [K9PythonController.py]
2017-03-12 Espruino Motor Encoder code
2017-03-19 Completely refactored Python Motor controller with PID capability
    Currently untested with real chassis so please do not use.
    Incorporates PID controller to enable feedback from encoders to be used
    to control motors.
2017-05-01 RoboClaw Python Library
    Adding RoboClaw Python Library and example python programs to enable
    the creation of a new motor controller that can work both manually
    (speed control) and under robot guidance (speed and distance control).
2017-05-06 Major update to K9 Python Controller for deployment to Pi
    New Python Motor Controller that uses the Roboclaw. Safety heartbeat
    mechanism now replaced by speed sensitive distance commands.
    [K9PythonController.py]
2017-05-06 Bug fixes to Motor Controller
    Tested version of Motor Controller working with encoders and Roboclaw
    motor controller. Correctly feeds actual motor speeds back to browser.
    [K9PythonController.py]
2017-05-13 Initial commit of enhancement to motor controller function for fine grained movement
    Creating a new steering mode via a fast/slow toggle switch on the motor
    controller tab. This will allow K9 to be steered ‘freestyle’ at high
    speeds and then controlled via fine grained forward, backward and spin
    movements at low speed. Changes required to motor controller tab,
    angular controllers and services, node-RED flows and Python motor
    controller.
2017-05-13 Syntax error in K9 Python Controller
    [K9PythonController.py]
2017-05-14 Re-enabling display of speed in browser
    Re-enabled feedback loop from robot status to browser without causing
    problems with toggle switches being immediately overridden. Changed
    display on motor controller to display mph rather than 0-100
2017-05-14 Cosmetic change to motor controller tab
    Making speed text default size and adding space before mph
2017-05-14 Minor cosmetic changes
    Changed “Control Speed” to the rather cooler “Turbo” mode. Changed
    motor controller debug print statements to accurately reflect what is
    going on
2017-05-14 Enabling support of Adafruit Servo Driver to enable control of lights and devices from within the motor controller (initially the hover lights)
    Adding the ability for the brightness of the hover lights to change as
    the motors are instructed to speed up or slow down.
2017-05-19 Motorclaw and PID changes
    New python routine to initialise NVRAM on motor controller. Additional
    enhancements to motor controller to pass details to node-RED including
    temperature, amps and volts.
2017-05-20 Changed deployment script to put motor controller into real, not test mode
    Minor fix to python path for PWM controller
    [K9PythonController.py]
2017-05-20 Modifications to work with latest Adafruit drivers
2017-05-20 Wrong scope for object
    [K9PythonController.py]
2017-05-20 Servo driver minor tweaks...
2017-05-20 Adding additional problem diagnosis
    [K9PythonController.py]
2017-05-20 Changed method name to avoid collision and then noticed lack of self variable in method definition - doh!
    [K9PythonController.py]
2017-05-20 Correcting currents tuple error
    [K9PythonController.py]
2017-05-20 Order of arithmetic error (hopefully)
    [K9PythonController.py]
2017-06-05 Partially debugged harness
    Harness is now generating data, but data needs to be manually checked
    or visualised and needs to be enhanced to send data to node-RED via a
    web socket.
2017-06-05 Fix of test harness
    Corrected JSON generation and changed websocket/node-RED endpoint.
    Created node-RED specific version that generates sensor messages every
    20ms.
    [node_RED_harness.py]
2017-06-05 Minor correction to time stamp of sensor readings
    [node_RED_harness.py]
2017-06-06 Changed angles to conform to same radian regime as atan (negative for below y axis)
2017-06-23 Additional web socket node for sensors to send data to
    Minor modification to K9 flows to add a specific web socket config and
    debug node to enable the test harness to start working.
2017-10-08 Addition of ultrasonic sensor neural net
    1. Ultrasonic sensor ground truth generator
    2. Two sets of ground truth (one set 1 used)
    3. Neural net creator and trainer
    4. Generated standalone JavaScript neural net for execution on Espruino
2017-10-11 New sensors graphic for Follow Me page
    New sensors graphic Illustrator and SVG files, plus a spreadsheet to
    translate between dog space and SVG points.
    [Map dog co-ords to SVG picture.xlsx]
2017-10-11 Modifications to sensors page
    Minor modification to Motor controller and test harness. Changes to
    sensor page to provide larger canvas for drawing test harness events
    [Map dog co-ords to SVG picture.xlsx]
2017-10-13 Analogue versions of previously generated neural net
    [xyanalog.xlsx]
2017-10-14 Espruino program to send xy co-ordinates of ultrasonic transducer to node-RED
    Simple Espruino program that maintains a rolling average of the last
    120ms of ultrasonic sensor readings and then sends them to node-RED as
    a set of x,y co-ordinates relative to the centre of the dog based on
    the interpretation of a trained neural net.
    [xyanalog.xlsx]
2017-10-15 node-RED flow
    This file represents the flows for K9 held in node-RED
2017-10-15 Revert "node-RED flow"
    This reverts commit 8075f1e1ef77e2dad9c1ce799c705f57724351f6.
2017-10-15 Espruino program that combines multiple ultrasonic sensor readings into a bearing
    Modifications to support an ultrasonic sensor array using a generated
    trained neural net on the Espruino, transmitting a bearing and distance
    to node-RED via USB which in turn transmits it to the app for display
    to the end user as a red line.
2017-10-19 Addition of 'Follow Me' Screen
    Addition of new template and minor changes to existing controllers,
    templates and AngularJS files. Cosmetic changes to SVG and Camera
    Image. Inclusion of JustGage gauges.
2017-10-27 Bug fix for Turbo toggle and enhancement to speed gages
    Dials now change colour (red/green/grey) and have correct units added.
    Turbo button also now works correctly.
    [K9PythonController.py]
2017-10-27 Modified sensor function to correctly use sensor origin
2017-10-27 Removal of sensors tab
    Removed sensors tab and relocated controller functionality to the
    Follow Me application page.
2017-10-28 Tessel directory
    Creation of Tessel directory for creation of Tessel 2 program to
    control LIDAR ear sensors.
2017-10-28 Refinement of ultrasonic visualisation
    Python test harness to enable testing and refinement of ultrasonic and
    IR proximity visualisation in browser. Removal of dedicated motor tab.
2017-11-19 Cosmetic changes to Follow Me page
    In response to some great UX and design feedback from the wonderful Pat
    D’Arcy I’m creating a new joystick and collision detection
    visualisation. This change temporarily deactivates the joystick
    directive.
2017-12-11 New ear controller and tessel experiment
    Add of untested Python based ear controller to work with LIDAR, ADC and
    PWM Servo controller. Plus unsuccessful Tessel 2 experiment to use
    LIDAR on that platform.
2017-12-11 Major rewrite of joystick directive to work with Snap.SVG rather than Canvas
    Major and untested rewrite of joystick directive, plus minor cosmetic
    change to K9PythonController
    [K9PythonController.py]
2017-12-11 Ear controller now running in simulation mode
    Debugged ear controller sufficiently to work correctly in simulation
    mode. Without sensors, recording a reading every 2-3ms.
    [ear_controller.py]
2017-12-11 Minor changes to ensure correct number of keys generated
    Changed MAX_SLOTS to a global constant and minor changes to logic to
    ensure right number of keys are generated
    [ear_controller.py]
2017-12-12 Addition of Connect to K9 button on Follow Me page.
    Tidying up of console.log entries and introduction of K9 connect button
    on Follow Me page. Syntax corrections to joystick directive. Addition
    of excuse me option to speech with polite tail wag. More speech
    options added.
2017-12-18 Switched to GPIO control of LIDAR sensors
    Changes to controller to enable 2 x LIDAR to sit on same I2C bus with
    ADC and PWM servo.
2017-12-18 Addition of mouth sensor
    Addition of mouth sensor for forward looking sensors.
2017-12-20 Switch from ADC Pi Plus to Adafruit ADS1115 ADC (16-bit)
    Minor changes to change ADC implementation to simpler Adafruit circuit.
2017-12-21 Initializing left and right motor speeds values in Redis
2017-12-22 Simplified ear tester to tune behaviour without LIDARs
2017-12-22 Even simpler servo driver
2017-12-29 Modifications based on testing and tuning
    Version of controller to check for ear behaviour. LIDAR removed to
    make testing easier.
2018-01-04 Back panel program for Espruino
    Sends messages to Pi via USB for changes in back panel switches and
    proximity readings from IR sensors.
2018-01-05 Minor debugging of the back panel program
    Test based on Espruino Pico, so not all ports exercised, but IR and
    switch function appears to be working on smaller subset.
2018-01-07 Addition of touch sensors to K9 back panel function
    Adding two touch capacitative touch sensors to K9’s sensory matrix.
    These will allow him to detect when he has been patted on his head or
    his back.
2018-02-01 Motor Controller redis integration
    Enabling the motor controller to read and write speed and encoder
    values to the shared Redis database. Minor change to the ear
    controller ensure common keys being used
2018-02-04 Integrating Redis short term memory
    Making Espruino and Python sensor messages consistent to enable them
    all to be used with K9’s Redis based short term memory
    [K9PythonController.py, ear_controller.py, memory.py]
2018-02-04 Integration of node-RED and Redis
    Enables the storing of sensor data received from the Epruinos via USB
    into the K9 Redis database
2018-02-06 Creation of observer program
    Simple Python program that will broadcast status of dog extracted from
    Redis via web socket every 200ms
2018-02-07 Creation of memory db extractor
    A python program that extracts information from the short term memory
    database for use in collision detection and display in the browser.
    [K9PythonController.py, memory.py, status.py]
2018-02-11 Added schematic keynote presentation
2018-03-10 Bug fixes for roboclaw interface calls
    First integration test
    [logo.py]
2018-03-10 Distances must always be positive...
    Modifications to roboclaw commands so that target velocities are
    signed, but distances are not
2018-03-10 Changing logic of waiting for motors to finish
2018-03-11 Reduced top speed of robot to prevent drive slip plus minor bug fix
    [logo.py]
2018-03-14 3D K9 models
    3D models for import into Gazebo ROS simulator
    [Doctor Who K9.stl]
2018-03-17 Short acceleration, long deceleration?
    [logo.py]
2018-03-17 More missing ) !
    [logo.py, test.py]
2018-03-18 Adding PID config to test
2018-03-30 Indentation issues
    Fixing indentation issues and commenting out Adafruit board for testing
    purposes
    [sb-wa-stt.py]
2018-03-30 Changing snowboy interrupt
2018-03-30 Forgot brackets!
2018-03-31 print syntax
2018-03-31 What is wrong now????
    [mic-speech-text-stream.py]
2018-03-31 Print syntax errors
2018-03-31 Remove PWM
2018-04-01 Original ttsrobot modified for new security and conversation
    Adopting the IBM Python SDK for Speech to Text using sockets doubled
    response time, so returning to original code and just using SDK for
    Conversation.
2018-04-01 Removing repeating prints
2018-04-02 Introducing silence timeout
    In May 2017 the timeout behaviour of the API changed, resulting in the
    original program not working; this is an attempt to get back to the
    original behaviour
    [assistant.py]
2018-04-02 Reduction in printed feedback
2018-04-15 Refinement to schematic, preparing for final integration
    Introduction of connections between shell and chassis
2018-04-22 Revision of boundary between body shell and chassis
    Significant simplification of the interface between chassis and body
    shell.
2018-06-17 Changes to schematic
2018-06-17 No encoder motor test
2018-06-17 Create a simple command line driver
2018-08-05 Changes after running on iPad
    Changed double-click on Joystick to single click as not supported on
    Safari. Doubled size of green button as too small for drag event to
    work reliably. Changed dial colours and ranges to properly reflect
    status.
2018-08-24 Added general robot schematic slide
2018-08-24 PID and QPPS changes
    Made changes to Roboclaw motor variables after housing rebuild and PID
    retuning.
2018-09-08 New Espruino program using the VL53L0X LIDAR module
    Servo positioning working, but unclear why LIDARs are not initialising
    on I2C2 bus. May be circuit rather than program error.
    [sensors_LIDAR_ears.js]
2018-09-09 Tuning parameters for LIDAR Ears
    Minor changes to use USB, prime numbers for intervals, servo timings
    and I2C bit rate to improve performance.
2018-09-10 Creation of models directory
    New directory for high level documentation and 3D models using Sketchup
    and TinkerCAD.
    [K9 Motor Housing.skp]
2018-09-10 3D models from TinkerCAD
    OBJ and STL files from TinkerCAD
    [K9 Ears Servo Arms.stl, K9 Infrared Back Panel (IR).stl, K9 logo.stl, K9 motor velco tops.stl, Motherboard pillars (front).stl, Second tier velcro pillars.stl, Wheel Encoder Holder.stl]
2018-10-01 Creation of simple test program for Servo ears
    Minor change to mathematics on Servo pulse for purposes of initial
    check.
2018-10-01 More efficient version of servo ears program
    More efficient version of servo ears program that pre-computes ear
    positions for each step once and stores them in an array. Enhancement
    not yet applied to LIDAR version.
2018-10-01 Update for espruino programs
    Addition of the ear servo test program and the combined
    LIDAR/servo/potentiometer program.
2018-11-25 Updates to LIDAR ears
2018-11-26 Changed angle to degrees, not radians; created average volts reading
2018-11-26 Addition of Redis server and update of node-RED flows
2018-11-27 Processing collections of sensor readings
2018-11-27 Update of UI to cope with LIDAR Data
    Addition of collection messages, addition of LIDAR data handling
2018-11-30 Revision of K9.svg to include edges of sensor field
2018-12-03 Merging of power and servo tabs
2018-12-03 Two column buttons?
2018-12-03 Lost button class
2018-12-05 Refreshing methods on power on/off tab
2018-12-05 Debugging sliders and switches
2018-12-05 Reverse switches
2018-12-05 Switches now working correctly
2018-12-27 Changes to reflect the wiring of the dog and the revision of the Servo Library
2018-12-27 Minor changes to sensor positions to reflect actual robot
2018-12-28 Processing servo and toggle messages in controller
    Plus lots of linter changes for code readability
2018-12-28 Minor tweaking of tail!
    Addition of tail initialisation and minor bug fix around movement
    [K9PythonController.py]
2018-12-28 Bug fixes to tail handling
    [K9PythonController.py]
2018-12-28 Reverting deletion of motorctrl
    [K9PythonController.py]
2018-12-28 Removal of GPIO and additional print...
2018-12-28 Hopefully simple fix for servo messages
    [K9PythonController.py]
2018-12-28 Type errors and switch of screen to PWM 6
    [K9PythonController.py]
2018-12-28 Resetting back to 100Hz
    [K9PythonController.py]
2018-12-28 Changing servo tuner to work with 100Hz pulses
2018-12-28 Changing tail numbers as a result of 100Hz recalibration
2018-12-28 Tweaks to UI for tail calibration
2018-12-29 Minor revisions to ultrasonic display
2018-12-29 Adjustments to back panel and sensor names
2019-01-05 Changes to dog behaviour and IR sensing
    Limits turning speed as a component of movement vector (turning at
    maximum 25% of forward speed - this may need to be further reduced to
    5%, but needs testing). IR sensing tweaked to allow for actual
    operating voltage of sensors and rogue readings.
2019-01-05 Checking calculations via debug prints
2019-01-05 Minor bug fixes to IR sensor array
2019-03-24 Integration of Espruino ultrasonic data collection with Python code
    The moving_avg_not_net is an adapted version of the existing neural net
    program that just collects data and sends it to the Pi in the same way
    that it would normally send data to the neural net. The us_data_col.py
    program collects that data and rotates the dog.
2019-03-26 changing print
2019-03-26 Change PID
2019-03-26 10 x PID
2019-03-26 Retuned PID
2019-03-26 Encoder pattern
2020-01-11 Revised encoder wheel design
    Larger encoder wheel to make them more reliable and accurate. This one has a diameter of 120mm and has 100 slots at 3.33mm pitch.
    [120mm encoder (3.33m gap, 200 clicks).stl]
2020-01-25 Revised motor controller (new encoder, new PID)
2020-01-26 Encoder based data collector
2020-01-27 Encoder based data collection program
2020-02-01 Refresh for new motor encoders
2020-02-01 Bug fixes for ACCELERATION and M2
    [K9PythonController.py]
2020-05-24 Revised flows and training files
2021-01-17 Update K9 Schematic.key
2021-03-02 Update K9 Schematic.key
    Schematic changes
2021-12-20 Documentation updates
    [Doctor Who K9.stl]
